Technology-for-the-Poorest-Billion/2026-SolarSafe-Heating/interim/TftPB Interim Presentation.pptx

## SOLARSAFE – Dehumidification

James Edwicker, Zac Heggie, Josh Tuckwell

## Josh – Concept Design

- The design goal is to increase the drying performance of the fan system.
- Restrictions on:
  - Power – Target of ~100W, with a strict maximum of 150W.
  - Cost – Any increase must be proportional to performance gains and remain affordable for sub-Saharan Africa.
  - Space and Mobility – The device must be portable to enable sharing between multiple farmers.

## Josh – Concept Design

- Brainstormed methods to increase drying performance:
  - Increase volumetric flow of air
  - Increase air temperature passing over the maize
  - Decrease inlet air humidity.

- Found that increasing temperature by 1°C is equivalent to reducing humidity by 4%

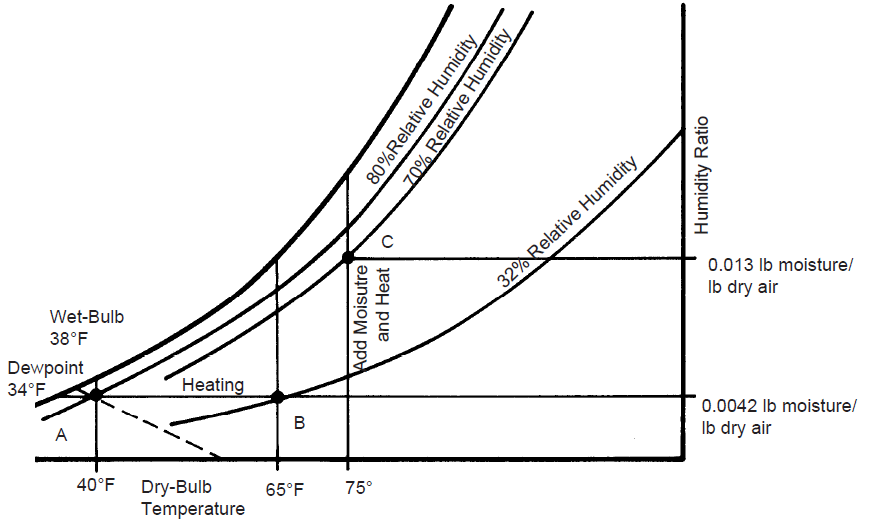
[picture p20: figure]

Source: Penn State Extension, 2023.

## Josh – Dehumidification

- Desiccant Dehumidification: Uses moisture-absorbing materials (like silica gel). Requires regular physical replacement or a high-temperature cycle to regenerate the material.
- Vapour-Compression Refrigeration: Drops air temperature below its dew point to condense out water. Highly effective but bulky, power intensive, and structurally complex.

Thermoelectric / Peltier Cooling: Solid-state condensation that strips moisture from the inlet air. No moving parts or toxic refrigerants.

## Josh – Peltier Devices

(

- Thermoelectric modules which actively transfer heat from one side of the ceramic substrate to the other using a DC current.
- Creates a local cold sink to drop inlet air below its dew point, forcing moisture to condense.

Key Advantages | System Limitations (Design Constraints)
Ultra-Compact | Low Thermodynamic Efficiency (COP) compared to mechanical cycles.
High Reliability: No compressors, valves, or fluid | Extraction rates are typically <1 litre of water per day.
Low Cost & Quiet | Optimised for small spaces

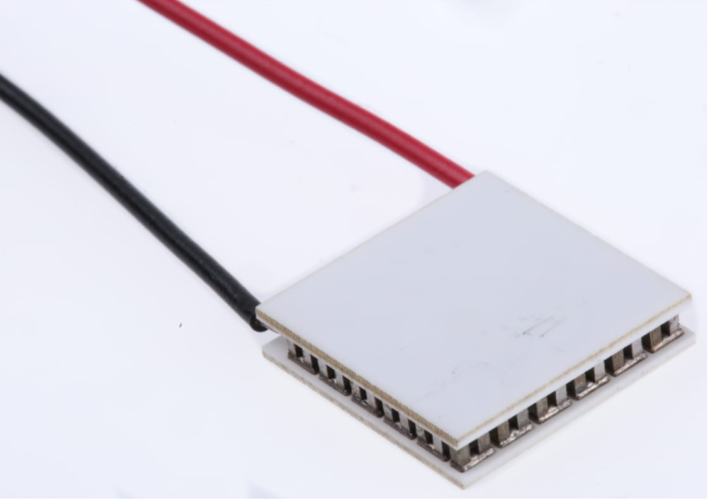
[picture p21: figure]
Adaptive Peltier Module, 11.7 W, 2.2 A, 8.8V, 10 mm x 18mm x 3.8 mm

## James – Rig Design

- Motor & fan selection
- Dehumidification parts
- Ducting routing
- Ducting cross-section
- Water management
- Air management


## James – Rig Design

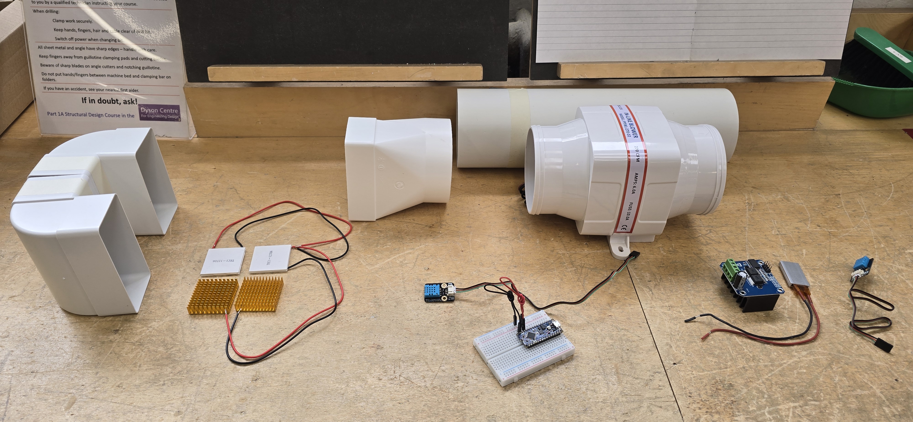
[picture p22: figure]

Peltier

Blower

180° Turn

Humidity & Temp Sensors

Temp Element

Controller

## James – Risk Assessment and Parts Sourcing

- Updating the risk assessment to meet departmental demands
- Filtering material and parts options to find suitable purchases
- Key issues:
  - Motor & fan
  - Ducts
  - Peltier heat sinks

## Zac – Electronics Architecture

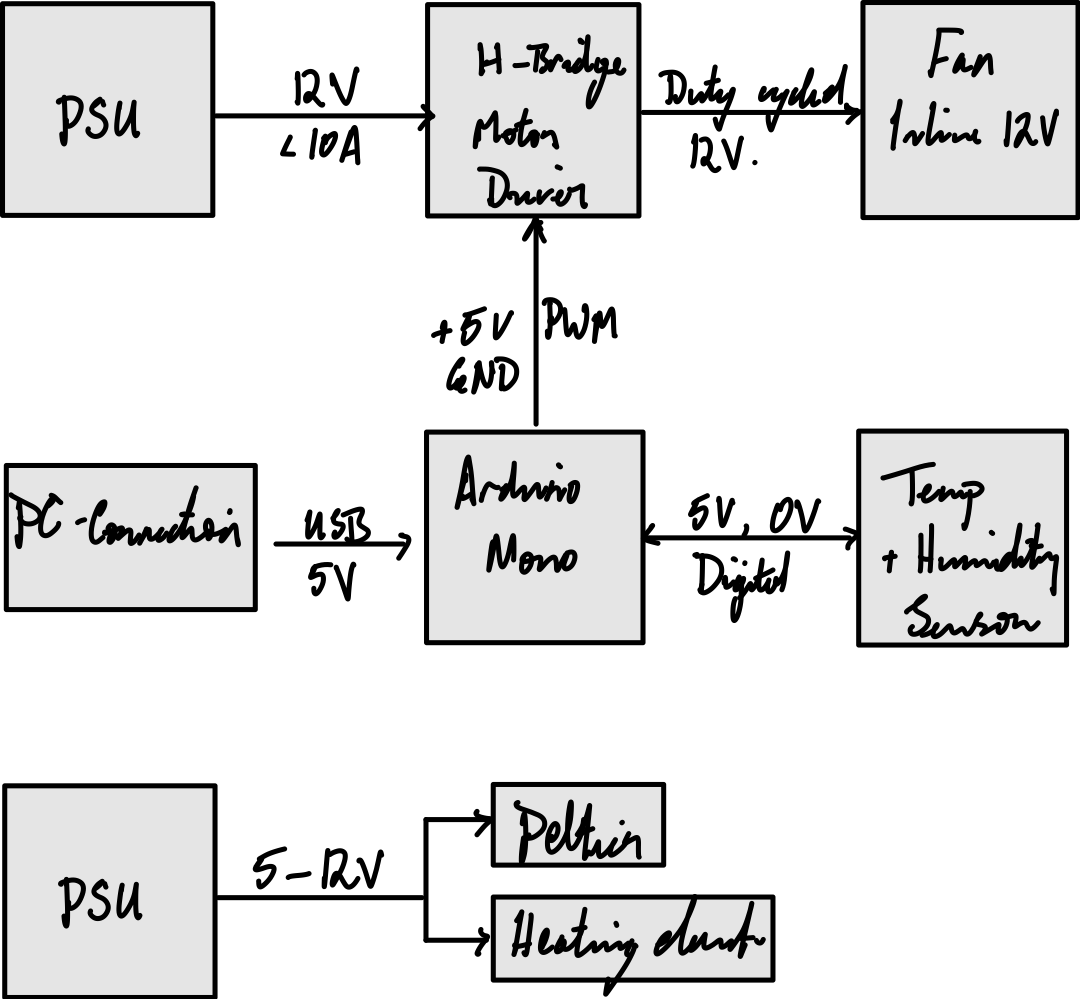
[picture p23: figure]

## Zac – Devices

- Gravity: DHT11 Temperature & Humidity Sensor For Arduino
- High Power Double DC Stepper Motor Driver Module Board H-Bridge PWM
- SEAFLO IN LINE BLOWER 12V 4" MARINE BOAT VENTILATION in-line air vent inline

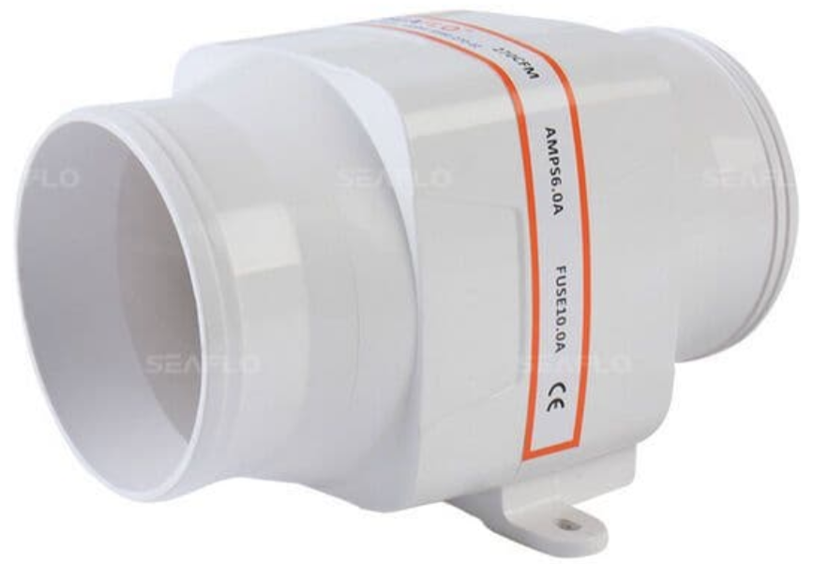
[picture p24: figure]
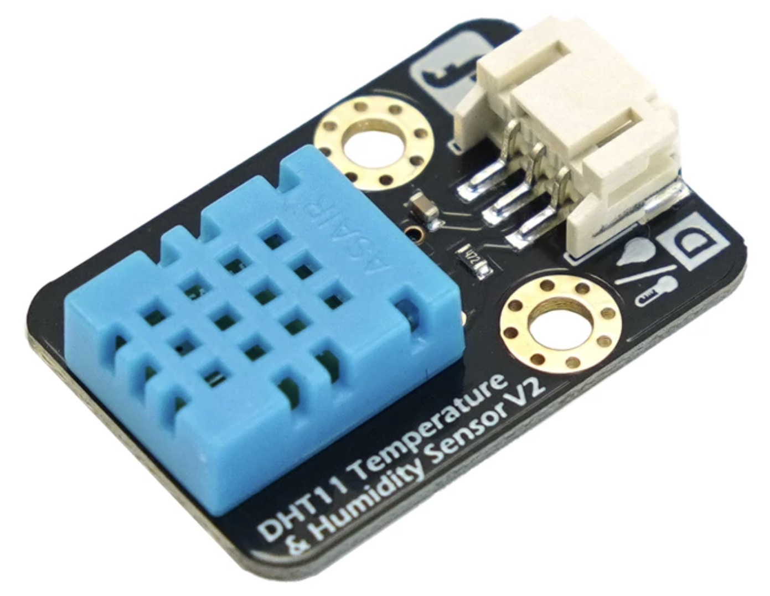
[picture p25: figure]
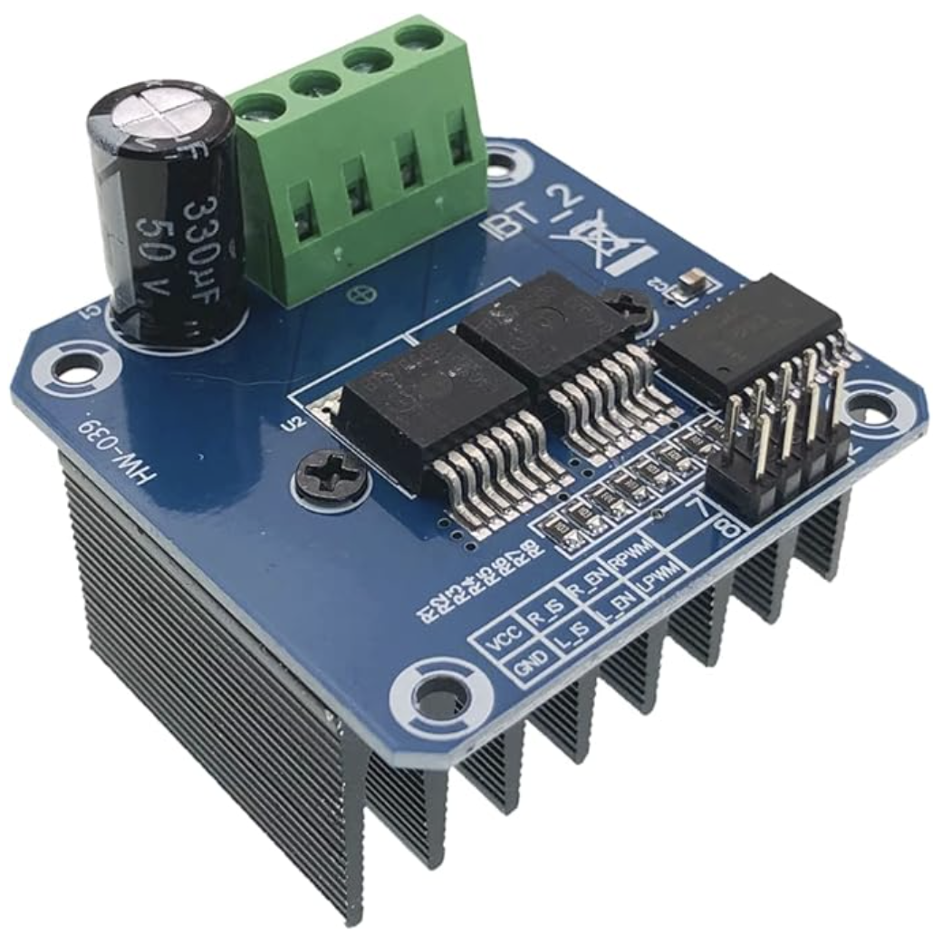
[picture p26: figure]

## Zac – Devices

- Thermoelectric Cooler Cooling Peltier Plate Module 12V 6A
- 12V AC DC Universal Constant Temperature Air Heater

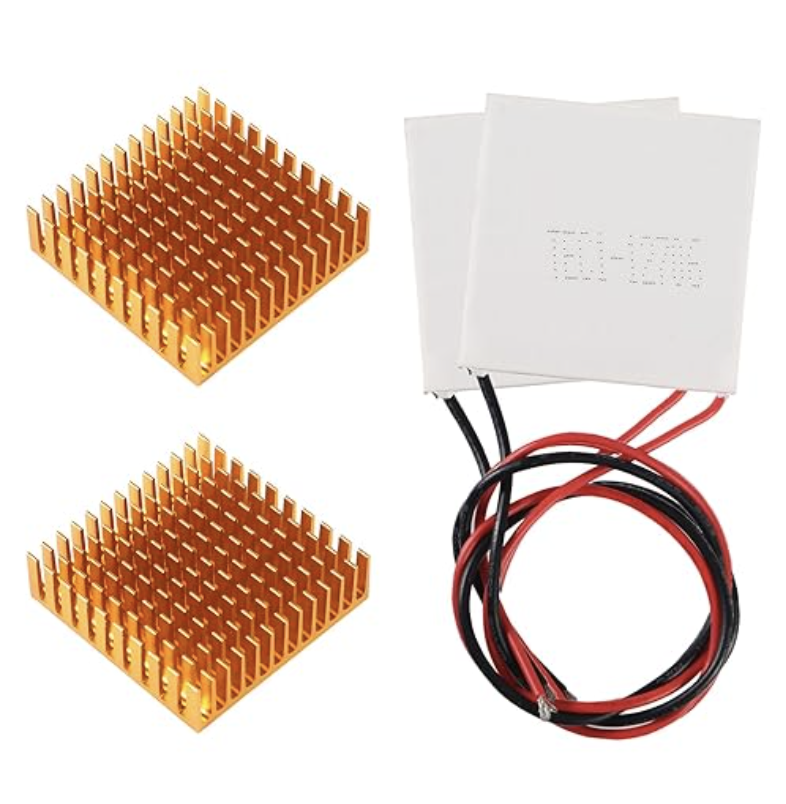
[picture p27: figure]
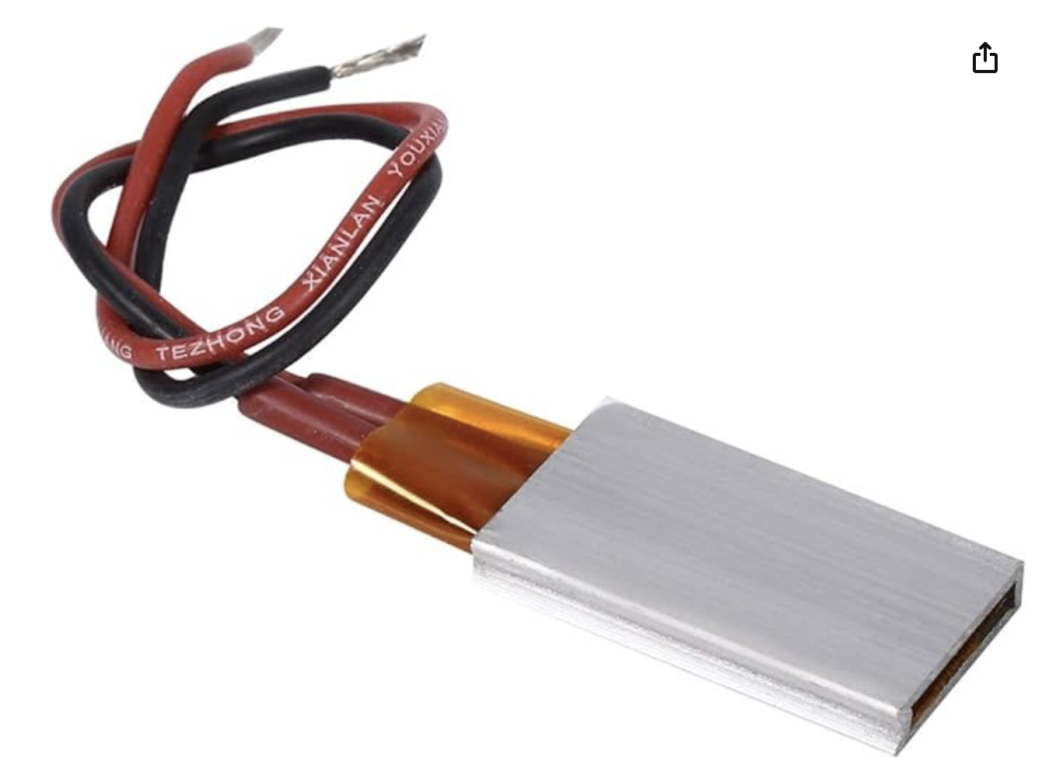
[picture p28: figure]

## Project Timeline Update

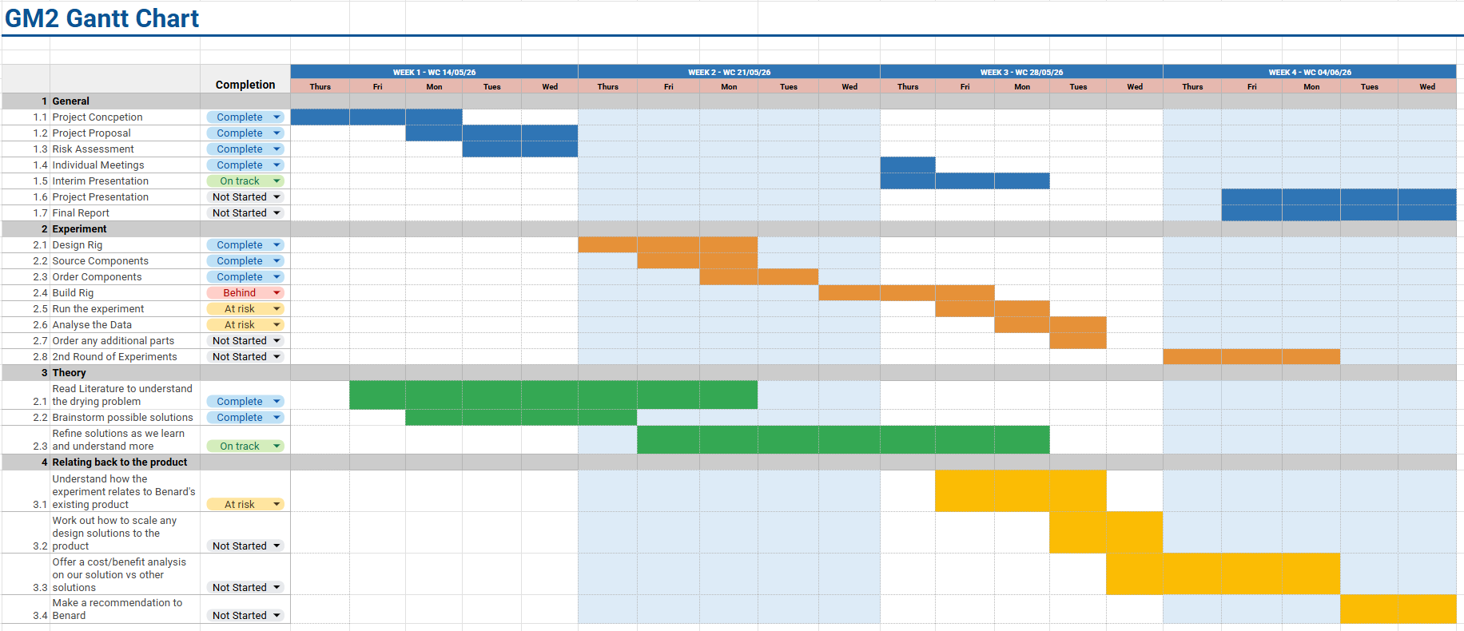
[picture p29: figure]
