Technology-for-the-Poorest-Billion/2026-SolarSafe-Heating/Information/Budgeting.xlsx

 | Components | Price | Source | Link
 | Fan/Motor | 38.47 | Amazon | Dilwe Marine Bilge Blower,Quiet Strong 12V Ventilation Fan,4 Inch In Line Electric Air Blower for Yacht Boat Caravan RV : Amazon.co.uk: Sports & Outdoors (https://www.amazon.co.uk/Marine-Blower-Electric-Ventilation-Caravan/dp/B0CT5LW2J1)
 | Peltier | 8.96 | Amazon | https://www.amazon.co.uk/ALAMSCN-TEC1-12706-Thermoelectric-Cooling-Heatsink/dp/B0CBDH4BHL
110mm x 54mm: length of straight section, 2x 90deg turn, adaptor, 100mm diameter: length of straight section. | Shroud/Duct PVC | 44.92 | Amazon | https://www.amazon.co.uk/Kair-110mm-Rectangular-Ducting-Length/dp/B01MZGSUAV
 |  |  |  | https://www.amazon.co.uk/Kair-Degree-Vertical-Elbow-110mm/dp/B004X4RUCK
 |  |  |  | https://www.amazon.co.uk/Kair-Offset-Straight-Rectangular-Adaptor/dp/B004X4S1K0
 |  |  |  | https://www.amazon.co.uk/Kair-Plastic-Ducting-Pipe-100mm/dp/B00YLIOWXI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
 | Heating Elements | 5.89 | Amazon | Jadeshay PTC Thermostat Heater Plate, AC/DC 12V PTC Heating Element Thermostatic Constant Temperature Aluminum Shell Ceramic Heating Plate Air Heater (2-5W 80°C) : Amazon.co.uk: Home & Kitchen (https://www.amazon.co.uk/Element-AC-Thermostatic-Aluminum-Constant-Temperature/dp/B07Y5DKHBH?th=1)
 | Heat Sinks | 8.19 | Amazon | https://www.amazon.co.uk/Heatsink-1-97x1-97x0-43-50mmx50mmx11mm-Amplifier-Transistor/dp/B0DPJTV3T1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
 | Humidity Sensors | 14.24 | The Pi Hut | DFR0067 | DFRobot Gravity: DHT11 Temperature & Humidity Sensor For Arduino, Arduino Compatible Kit | RS (https://uk.rs-online.com/web/p/arduino-compatible-boards-kits/2163753?matchtype=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)
 | Temperature Sensors
 | Control Board | 13.31 | RS-online | ABX00033 | Arduino Nano Every with headers | RS (https://uk.rs-online.com/web/p/arduino/1927590)
 | H Bridge | 7.19 | Amazon | JZK BTS7960B 43A High Power Double DC Stepper Motor Driver Module Board H-Bridge PWM for Smart Car : Amazon.co.uk: Business, Industry & Science (https://www.amazon.co.uk/JZK-BTS7960B-Double-Stepper-H-Bridge/dp/B09HGBM5D2)
 | Total | 133.98
 | Misc. Electronics
 | Bread board
 | Jumper wires
 | USB micro-b / micro USB (depending on model of arduino)
 | Misc passives
 | Thermal Paste
