Technology-for-the-Poorest-Billion/2026-SolarSafe-Heating/Information/Fan and motor options.xlsx

Sheet: Rough Options
Fan type | Airflow | Static pressure | Power
PC axial fan | Low | Low | Low
Bathroom extractor | Low | Medium | Medium
Car radiator fan | High | Medium - High | High
Centrifugal blower / inline duct fan | Medium | High | Medium

Sheet: Comparison with Real Examples
Motors & Fans - SOLARSAFE |  |  | ~: data does not come from product page but is infered from general performance of fans of this design
 | Fan Type | Power (W) | Voltage (V) | Price (£) | Diameter (mm) | Static Pressure Rise (Pa) | Volumetric Flow Rate (m^3/s) |  | Example link
 | Computer | 1.44 | 12 | 5 - 20 | 120 | ~30 | 0.0163 | 0.01131944444 | https://www.amazon.co.uk/ARCTIC-P12-SLIM-PWM-Pressure-optimised/dp/B08QDKGCCW
 | Car Radiator | 80 | 12 | 20 - 40 | 203.2 - 406.4 | ~140 | 0.7 | 0.00875 | https://shop.stoneyracing.com/products/universal-slimline-12v-electric-car-radiator-intercooler-ac-cooling-fan
 | Bathroom Extractor | 12 | 240 AC | 20 - 80 | 100 | ~60 | 0.0211 | 0.001758333333 | https://www.screwfix.com/p/xpelair-vx100t-100mm-4-axial-bathroom-extractor-fan-with-timer-white-220-240v/2659d
 | Inline Duct Fan | 5 | 12 | 22 | 110 | ~80 | 0.0417 | 0.00834 | https://www.ebay.co.uk/itm/137080143677?var=0&campid=5338749401&toolid=20006&_ul=GB|0AAAAADihhqUscqrt4X8StZbykCGLWemUz|Cj8KCQjw_b_QBhDzARIuAJnMvpvNfBinH8ct2iXrbJZ-OHEV34c7469rB-GmRb3zRGhanEQkx3L0WnvbmRoCbQ0&loc_interest_ms=&loc_physical_ms=9044914&adtype=pla&gad_source=1&gad_campaignid=22857718300
 | Centrifugal Duct Fan | 60 | 240 AC | 53 | 100 | ~300 | 0.0986 | 0.001643333333 | https://www.techvent.co.uk/centro-in-line-centrifugal-tube-duct-mounting-extraction-fan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
 | Bilge Ventilator | 48 | 12 | 20 - 40 | 76.2 - 101.6 | ~250 | 0.111 | 0.0023125 | https://www.amazon.co.uk/Inline-Blower%EF%BC%8C4-Blower-Marine-Ventilation/dp/B0932Z1LP3

Sheet: Budgeting
 | Components | Price | Source | Link
 | Fan/Motor | £38.47 | Amazon | Dilwe Marine Bilge Blower,Quiet Strong 12V Ventilation Fan,4 Inch In Line Electric Air Blower for Yacht Boat Caravan RV : Amazon.co.uk: Sports & Outdoors (https://www.amazon.co.uk/Marine-Blower-Electric-Ventilation-Caravan/dp/B0CT5LW2J1)
 | Peltier | £8.96 | amazon | https://www.amazon.co.uk/ALAMSCN-TEC1-12706-Thermoelectric-Cooling-Heatsink/dp/B0CBDH4BHL
2x T Junction, 2x 90deg turn/1x 180deg turn, length of straight section. | Shroud/Duct | £32.80 | B&Q | My basket at B&Q (https://www.diy.com/basket)
 | Heating Elements
 | Heat Sinks | £8.19 | amazon | https://www.amazon.co.uk/Heatsink-1-97x1-97x0-43-50mmx50mmx11mm-Amplifier-Transistor/dp/B0DPJTV3T1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
 | Humidity Sensors | £7.80 | The Pi Hut | DHT11 Temperature-Humidity Sensor - The Pi Hut (https://thepihut.com/products/dht11-temperature-humidity-sensor)
 | Temperature Sensors
 | Control Board | £13.31 | RS-online | ABX00033 | Arduino Nano Every with headers | RS (https://uk.rs-online.com/web/p/arduino/1927590)
 | Motor driver | £7.19 | Amazon | https://www.amazon.co.uk/JZK-BTS7960B-Double-Stepper-H-Bridge/dp/B09HGBM5D2
 | Total | £116.72
 | Misc. Electronics
 | Bread board
 | Jumper wires
 | USB micro-b / micro USB (depending on model of arduino)
 | Misc passives
