Technology-for-the-Poorest-Billion/2026-SolarSafe-Heating/Scripts/control_with_logging/open_to_close_test_1.csv

elapsed_ms | inlet_temp_c | inlet_rh_pct | outlet_temp_c | outlet_rh_pct | fan_pct | inlet_ok | outlet_ok
696 | 23.0 | 35.0 | 23.0 | 34.0 | 75 | 1 | 1
3391 | 23.0 | 35.0 | 23.0 | 34.0 | 75 | 1 | 1
6086 | 23.0 | 35.0 | 23.0 | 34.0 | 75 | 1 | 1
8782 | 23.0 | 35.0 | 23.0 | 34.0 | 75 | 1 | 1
11478 | 23.0 | 35.0 | 23.0 | 34.0 | 75 | 1 | 1
14173 | 23.0 | 35.0 | 23.0 | 35.0 | 75 | 1 | 1
16868 | 23.0 | 35.0 | 23.0 | 35.0 | 75 | 1 | 1
19564 | 23.0 | 36.0 | 23.0 | 35.0 | 75 | 1 | 1
22259 | 23.0 | 36.0 | 23.0 | 36.0 | 75 | 1 | 1
24954 | 23.0 | 37.0 | 23.0 | 36.0 | 75 | 1 | 1
27650 | 23.0 | 37.0 | 23.0 | 36.0 | 75 | 1 | 1
30345 | 23.0 | 38.0 | 23.0 | 37.0 | 75 | 1 | 1
33041 | 23.0 | 38.0 | 23.0 | 37.0 | 75 | 1 | 1
35736 | 23.0 | 38.0 | 23.0 | 37.0 | 75 | 1 | 1
38431 | 23.0 | 39.0 | 23.0 | 37.0 | 75 | 1 | 1
41127 | 23.0 | 39.0 | 23.0 | 38.0 | 75 | 1 | 1
43823 | 23.0 | 39.0 | 24.0 | 38.0 | 75 | 1 | 1
46518 | 23.0 | 39.0 | 24.0 | 38.0 | 75 | 1 | 1
49214 | 24.0 | 39.0 | 24.0 | 38.0 | 75 | 1 | 1
51909 | 24.0 | 39.0 | 24.0 | 38.0 | 75 | 1 | 1
54604 | 24.0 | 39.0 | 24.0 | 38.0 | 75 | 1 | 1
57299 | 24.0 | 39.0 | 24.0 | 38.0 | 75 | 1 | 1
59996 | 24.0 | 39.0 | 24.0 | 38.0 | 75 | 1 | 1
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
