Technology-for-the-Poorest-Billion/2026-SolarSafe-Heating/Scripts/control_with_logging/open_to_close_test_2_dry.csv

elapsed_ms | inlet_temp_c | inlet_rh_pct | outlet_temp_c | outlet_rh_pct | fan_pct | inlet_ok | outlet_ok
696 | 22.0 | 33.0 | 27.0 | 29.0 | 75 | 1 | 1
3391 | 22.0 | 33.0 | 27.0 | 29.0 | 75 | 1 | 1
6086 | 22.0 | 34.0 | 27.0 | 29.0 | 75 | 1 | 1
8782 | 22.0 | 34.0 | 27.0 | 29.0 | 75 | 1 | 1
11478 | 21.0 | 35.0 | 27.0 | 29.0 | 75 | 1 | 1
14173 | 21.0 | 35.0 | 27.0 | 29.0 | 75 | 1 | 1
16869 | 21.0 | 35.0 | 27.0 | 29.0 | 75 | 1 | 1
19564 | 21.0 | 36.0 | 27.0 | 29.0 | 75 | 1 | 1
22259 | 22.0 | 36.0 | 27.0 | 29.0 | 75 | 1 | 1
24954 | 22.0 | 36.0 | 27.0 | 29.0 | 75 | 1 | 1
27651 | 23.0 | 36.0 | 27.0 | 29.0 | 75 | 1 | 1
30346 | 23.0 | 36.0 | 27.0 | 30.0 | 75 | 1 | 1
33041 | 24.0 | 36.0 | 27.0 | 30.0 | 75 | 1 | 1
35736 | 25.0 | 36.0 | 28.0 | 29.0 | 75 | 1 | 1
38432 | 25.0 | 35.0 | 28.0 | 29.0 | 75 | 1 | 1
41127 | 26.0 | 35.0 | 28.0 | 29.0 | 75 | 1 | 1
43823 | 27.0 | 34.0 | 28.0 | 30.0 | 75 | 1 | 1
46518 | 27.0 | 33.0 | 28.0 | 29.0 | 75 | 1 | 1
49213 | 27.0 | 32.0 | 28.0 | 28.0 | 75 | 1 | 1
51909 | 28.0 | 32.0 | 29.0 | 30.0 | 75 | 1 | 1
54604 | 28.0 | 31.0 | 29.0 | 29.0 | 75 | 1 | 1
57299 | 28.0 | 30.0 | 29.0 | 29.0 | 75 | 1 | 1
59996 | 28.0 | 30.0 | 29.0 | 29.0 | 75 | 1 | 1
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
