Technology-for-the-Poorest-Billion/2026-SolarSafe-Heating/(commit log)

2026-05-23 Initial look at fan and motor options
    [Fan and motor options.xlsx]
2026-05-23 More motor options
    [Fan and motor options.xlsx]
2026-05-25 PVC pipe and motor options
    [Fan and motor options.xlsx]
2026-05-26 Added electronics to parts list
    [Fan and motor options.xlsx]
2026-05-26 Separated the budget from the motors.
    [Budgeting.xlsx]
2026-06-05 Revise landing page title and introduction content
    Updated the landing page title and expanded the introduction with information about maize harvest issues in Kenya.
2026-06-06 Enhance index.md with SOLARSAFE project details
    Added sections about the SOLARSAFE prototype and project contributions to the index.
2026-06-08 Added more scripts
    [run_001.csv]
2026-06-09 Updated to set fan at 1
2026-06-09 Default to fan speed at 75%
    [run_001.csv]
2026-06-09 Added test results
    [close_to_open.csv, open_to_close_test_1.csv, open_to_close_test_2_dry.csv]
2026-06-10 Document results of humidity reduction experiments
    Added results and findings from the device testing, including performance metrics and recommendations for future experiments.
2026-06-10 Add mechanical design report
    Added James Edwicker's individual report on mechanical design, detailing the prototyping process, ducted blower selection, duct design, construction challenges, and iteration of the design.
2026-06-11 Fix typos.md
    Corrected typos and improved clarity in the text regarding the maize harvest and the SOLARSAFE prototype results.
